sjsjksjxmxmsm/2025e-/docs/手册图_K230接线.jpg

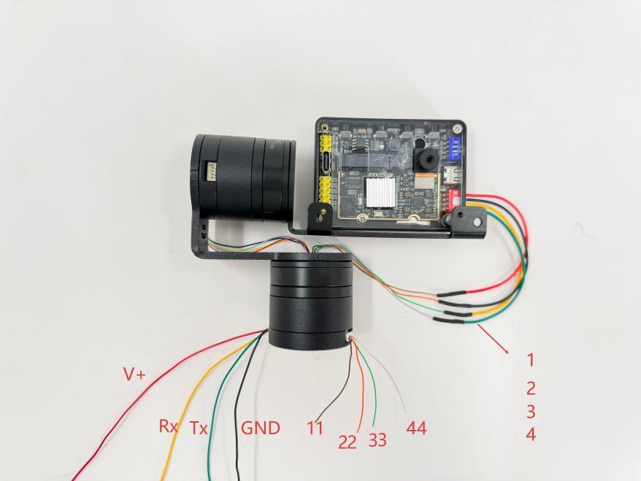
docs/手册图_K230接线.jpg
