sjsjksjxmxmsm/2025e-/docs/实验室大二培训_个人报告.docx

实验室大二培训·个人实践报告

2025 年全国大学生电子设计竞赛 E 题｜简易自行瞄准装置

姓名：____陈俊宇________ 提交日期：2026 年 11 月 ____ 日

本人主要负责：云台与视觉的硬件接线、下位机（STM32）固件开发与联调、激光瞄准补偿标定

填写说明

本报告用于了解你在项目中的真实参与、技术理解和成长过程，不是团队总结，也不是完整的技术论文。请使用自己的语言，如实记录；可以插入图片、关键代码、测试记录及参考来源。文字不必冗长，但要尽可能具体。尚未完成或尚未解决的问题可以直接说明。

# 一、小组分工与个人成果

成员/角色 | 负责内容 | 协作关系或备注
本人： | K230识别，云台电机通信与运动控制、K230 视觉串口通信、MPU6050 陀螺仪接入、OLED 显示、激光补偿标定， | 负责下位机全部固件与接线，是整机联调的接口人
其他成员： | 寻线（循迹）板程序，运行在另一块 MCU 上 | 本板从寻线板接收转向意图；实际转向补偿改由本板陀螺仪自行测量

1. 我的具体任务及实现方法：

本项目中途更换过一次主控板（从厂家原板换到“江协 32 核心板 + 功能底板”，芯片由 STM32F103C8 换成 STM32F103RCT6）。换板之后所有引脚都要重新确认，所以我实际做的工作可以分成四块：

（1）摸清板子并把外设接对。原工程的引脚在新板上一半以上都冲突（例如 PB8 被 OLED 的复位脚占用，而原工程用它接陀螺仪）。我逐个模块查原理图、配合万用表实测，最终确定：云台走 USART1（PA9/PA10，板上 H4 的 TXD1/RXD1）；K230 走 USART3 的默认引脚 PB11（板上 GX_SDA）；MPU6050 用软件 I2C 挂在 PB6/PB7（板上 BL_SCL/BL_SDA，与板载 EEPROM 共总线）；OLED 用四线 SPI 走 PB3/PB4/PB5 加 PB8 复位。

（2）云台电机通信。云台是两轴 BLDC，协议为 0x7A | 地址 | 命令 | 数据 | 校验 | 0x7B，校验为前面字节的异或。实测这台云台的 2 号电机是下面底座（偏航），1 号电机是上面横臂（俯仰），与手册默认顺序相反。偏航用速度模式（发转速），俯仰用多圈位置模式（发绝对角度），这样才能保证俯仰角不漂。

（3）视觉链路。K230 每帧发 8 字节：0x7B、x 高、x 低、y 高、y 低、面积高、面积低、0x7D，坐标是相对画面中心的像素偏移并加了 32768 偏置。STM32 侧用 USART3 的 DMA 加空闲中断接收，收到后解析成 X/Y/面积。实测稳定在 35～38 fps。

（4）闭环控制与激光补偿。用 TIM2 产生 5 ms 周期中断（200 Hz），在中断里跑视觉 PD：误差 = 瞄准点 − 目标像素位置，输出偏航转速与俯仰目标角。瞄准点不是画面中心，而是“激光正好打中目标时目标所在的位置”，这个偏移随距离变化，所以我又用目标面积（面积与距离平方成反比）换算出 √面积，用 √面积做线性修正，实现随距离自适应的补偿。

2. 个人成果与佐证：

成果/完成情况 | 证据位置（截图、代码、测试记录等） | 我的具体贡献
云台能锁定目标并实时跟踪 | OLED 上 N 值稳定增长（35 左右）、X/Y 随目标移动平滑变化 | 独立完成电机协议、控制环与调参
K230 视觉链路打通 | 断电重启后 N 值持续增长；软件 I2C 扫描能同时看到 0x50(EEPROM) 与 0x68(MPU) | 独立完成帧协议对接与故障定位
陀螺仪偏航前馈生效 | OLED 的 G 字段随转动变化；快速甩动装置时云台反向抵抗 | 独立完成软件 I2C 驱动与零偏校准
激光能命中目标中心 | 近距离（面积约 59000）与远距离（面积约 16000）两点实测均命中 | 独立完成两点标定与模型推导
按键触发搜索 | 不按键时不转动，按下后 X 轴慢速扫描；检测到目标立即接管 | 独立完成按键逻辑与状态机

[在此插入必要的实物照片、接线图、代码片段、测试截图等，并注明图题/来源。]

# 二、遇到的问题与解决过程

环节 | 具体记录
问题现象 | 俯仰轴（1 号电机）使能后有保持力、能锁住，但给位置指令完全不动作；同一套代码发速度指令给偏航轴（2 号）却正常。
分析与判断 | 先后排除了接线（万用表确认共地、电平正常）、地址（上位机确认 1 号在线）、使能（电机确实锁住）三个方向后，判断问题出在“位置模式的命令本身没被电机执行”。
采取的尝试 | 第一步试了单圈位置模式 0x0004、0x0002，发两字节角度，无效；第二步换成手册里写明的多圈位置模式 0x0001、改发四字节绝对角度，仍然不动；第三步去翻厂家给的“位置闭环”官方例程，逐行对照。
验证结果 | 对比发现官方例程里有一句我们漏掉的关键设置：位置模式下也要发一次非零的速度（官方用 50）。我们把初始化里的 BLDC_SetSpeed(Y, 0) 改成 30 后，俯仰轴立刻开始正常跟随。
最终结论 | 这颗电机的“多圈位置模式”是带 T 型轨迹规划的：速度参数就是轨迹里匀速段的速度。设为 0 等于要求它以 0 速度走到目标位置，永远到不了，表现出来就是“使能了但不动”。这也解释了为什么速度模式下同样的 0 值没问题——速度模式不规划轨迹。

除上面这个主问题外，这段时间还踩了不少坑，按“现象—原因—解决”整理如下：

① 万用表找不到引脚。现象：知道要用 PB11 接 K230，但板上排针几十根，不知道哪根是 PB11。解决：写了一个“引脚扫描”程序，把几个候选脚同时翻转但占空比不同（50%/30%/12%），万用表量到的平均电压就分别是 1.65V、0.99V、0.40V，一次就能对上号。

② 硬件 I2C 一个设备都扫不到。现象：用 STM32 硬件 I2C1 扫描，连板上已经焊死的 EEPROM 都没应答。分析：怀疑是硬件 I2C 的配置或总线状态有问题。解决：改用软件位翻转（开漏输出 + 自己打时序），同一套引脚立刻扫到了 0x50 和 0x68 两个设备，问题定位在硬件外设这一层，驱动就全部改用软件 I2C。

③ 屏幕能亮但内容是倒的、右边缺两列。分析：查驱动芯片手册发现板上用的是 SH1106 而不是常见的 SSD1306，显存是 132 列、屏只有 128 列，且 COM 扫描方向默认相反。解决：初始化命令 0xC8 改 0xC0 解决上下颠倒，写列地址时统一加 2 的偏移解决左右错位。

④ 上电时俯仰轴猛地甩一下。分析：多圈位置模式的“0 度”是电机自己的绝对零点，不是上电时横臂所在的位置，第一个指令等于让它朝绝对零点冲过去。解决：上电后先发一次“读实际角度”，把这个值存成基准偏移，之后所有角度指令都加上这个偏移；再补一个 1 秒的静默期，让电机先停稳再开始跟踪。上电甩动消失。

⑤ 目标回不到画面中心，总是差一截。分析：代码里有个从原厂例程继承下来的标定值 VISION_CENTER_Y = 9，意思是“瞄准点在画面中心下方 9 像素”，换摄像头后这个值早就没意义了。解决：把 X/Y 的标定残留清零，改成按实测重新标定。

⑥ 误差很小时云台完全不动。分析：俯仰指令累加前做了取整，仰角指令 = round(Kp × 误差)，Kp 是 0.01 时误差小于 50 像素取整结果就是 0，等于有一圈 50 像素的死区；偏航轴同理。解决：两轴都改成“小数累加”——把不足 1 个单位的指令攒在 float 里，攒够 1 再发一次，这样误差再小也能慢慢磨过去，同时不会像“每拍强行走一步”那样冲过头。

⑦ 脱靶后云台往反方向跑。分析：K230 丢目标时发的是 send_target(0, 0, 0)，而 STM32 侧每一帧都更新坐标，于是“最后位置”被 0 覆盖了，“回到最后位置”就变成了“回到画面正中”，方向自然反了。解决：改成只有带目标的帧（面积不为 0）才更新坐标，丢目标的帧保留最后一次有效位置。

⑧ 控制环只在收到帧的那一拍才计算。现象：俯仰指令 99% 的时间是 0，云台像卡住一样。分析：原来用了一个“收到帧”的一次性标志，而视觉 38 fps、控制环 200 Hz，等于每 5 拍里只有 1 拍在算 PD，其余 4 拍都在走搜索分支把指令清零。解决：改成用“帧号有没有变化”判断新数据，没有新数据时用上一帧的值继续算，这样每拍都在闭环里。

⑨ 目标闪一下就开始乱转。分析：只要有一帧面积变成 0 就立刻重新进入搜索。解决：加迟滞——只有连续 200 ms（约 7~8 帧）都没有有效目标才算真丢失。

⑩ 激光笔和镜头不在同一光轴，靠近了打不中。分析：这是视差，偏移量和“激光到镜头的距离 ÷ 目标距离”成正比，目标越远偏移越小。解决：用目标面积反推距离（面积与距离平方成反比），拟合出“瞄准偏移 = 常数项 + 系数 × √面积”的线性模型，只在近、远两个点各测一组数据就能解出这两个未知量，中间距离自动插值。实测两点都命中。

相关证据（如适用）：[插入调试照片 / 日志 / 参数前后对比]

# 三、学习经历与个人收获

学习内容 | 项目开始前的状态 | 学习过程和当前掌握程度
STM32 串口 + DMA + 空闲中断接收 | 只会串口轮询收字节 | 能独立配置 USART+DMA+IDLE 定长帧接收，理解中断优先级与 DMA 通道映射
BLDC 云台协议 | 完全没接触过 | 能看懂帧格式与校验，会拿官方例程反查自己的错误，理解速度/位置/轨迹三者的区别
软件模拟 I2C | 只知道有这个概念 | 能手写位翻转时序（起始、应答、读写），会写总线扫描程序定位地址
无示波器条件下的调试手段 | 只会加 printf | 会用 GPIO 翻转 + 万用表读平均电压来定位引脚、判断信号有无
PID/PD 参数整定 | 只会背公式 | 理解了采样延迟、量化取整、执行器死区对闭环的实际影响，知道“调参数前先测数据”

这次经历中让我印象最深的一项变化（结合具体例子）：

最大的变化是：从“改参数碰运气”变成“先把数据测出来再动手”。

刚上手时，云台一抖我就去改 KP，改完还抖就再改，一个下午换了十几次参数也没个头绪。后来我开始强迫自己先回答三个问题：目标现在到底在画面哪个位置？K230 还看得见它吗？电机收到指令了吗？——只要有任何一个问题答不上来，就不许动参数。

比如俯仰轴不动那次，我一开始也是一直在试模式值（0x0004、0x0002、0x0001 挨个试），折腾了很久。真正解决问题的一步其实是去翻官方例程、把自己发的帧和官方逐字节对比，这才发现差的不是模式而是那个“速度 = 0”。如果一开始就这么查，能省掉大半天。

还有 OLED 那次，一直以为驱动写错了，最后查到板上用的是 SH1106 而不是 SSD1306，换了两条初始化命令就好了。这件事让我意识到：先确认硬件是什么，再谈软件怎么写。

# 四、项目复盘与下一步

1. 目前成果中还有哪些不足，或哪些任务未完成？主要原因是什么？

（1）大误差时仍会过冲。视觉只有 35～38 fps，加上串口和解析的延迟，闭环里大概有 30 ms 的滞后；增益一旦调大就振荡，调小又跟不上，目前是取了一个折中的小增益。

（2）激光补偿只用近、远两点标定，中间距离没有实测验证，模型是否真的线性还缺少第三个点的证据。

（3）俯仰轴是“开环的位置模式”——目标角度靠软件累加，没有读回电机的实际角度。如果横臂被挡住或电机丢步，软件并不知道，长时间运行会有累积偏差。

（4）代码结构比较乱。为了不新建工程文件，我把 MPU6050 的驱动直接塞进了 control.c 里，几百行的控制逻辑和 I2C 时序混在一起，后面自己回头看也要找半天。

2. 如果再给自己一些时间，我会优先改进什么？准备如何验证？

优先改进的第一件事是把俯仰轴改成真正的闭环：用电机回传的实际多圈角度（FB_MULTI_ANGLE）替代软件累加值，这样限位、过冲、丢步都能被真实反映。验证方法是：故意用手挡住横臂让它走不动，再放开，看它能不能自己回到正确角度。

第二件事是让视觉更稳：在 K230 端加“连续 N 帧确认 + 检测框滑动平均”，减少框的跳动；或者在 PD 之外加一个基于目标速度的前馈项，减小滞后。验证方法是记录一段 X/Y 曲线，看抖动幅度有没有下降。

第三件事是补第三个标定点验证激光补偿模型；如果发现不是线性，就改成在图像里直接检测激光亮点做闭环对准，那样任何距离都准。

3. 接下来希望继续学习或尝试的方向：

• 运动控制方向：系统辨识与自整定，学会用频响/阶跃响应来定增益，而不是靠手调。

• 嵌入式软件结构：把代码拆成清晰的驱动层/控制层/应用层，或者尝试用 FreeRTOS 管理多任务。

• 图像处理：激光点检测、亚像素定位，这是把“开环补偿”变成“闭环对准”的关键。

• 调试工具：想学一学用逻辑分析仪和 SWO 打点，比万用表和 printf 效率高得多。
