sjsjksjxmxmsm/2025e-/docs/手册图_云台正反面.jpg

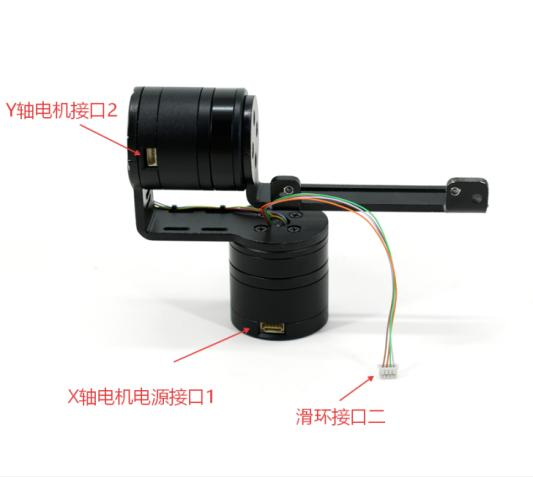
docs/手册图_云台正反面.jpg
