sjsjksjxmxmsm/2025e-/(commit log)

2026-11-08 add firmware/MiniBalance_HARDWARE/BLDC_GIMBAL/DataScope_DP.c
2026-11-08 add firmware/MiniBalance_HARDWARE/ENCODER/encoder.c
2026-11-08 add firmware/MiniBalance_HARDWARE/ENCODER/encoder.h
2026-11-08 add firmware/MiniBalance_HARDWARE/MOTOR/motor.c
2026-11-08 add firmware/MiniBalance_HARDWARE/MOTOR/motor.h
2026-11-08 add firmware/STM32F10x_FWLib/inc/misc.h
2026-11-08 add firmware/STM32F10x_FWLib/inc/stm32f10x_adc.h
2026-11-08 add firmware/STM32F10x_FWLib/inc/stm32f10x_crc.h
2026-11-08 add firmware/STM32F10x_FWLib/inc/stm32f10x_dbgmcu.h
2026-11-08 add firmware/STM32F10x_FWLib/inc/stm32f10x_can.h
2026-11-08 add firmware/STM32F10x_FWLib/inc/stm32f10x_exti.h
2026-11-08 add firmware/STM32F10x_FWLib/inc/stm32f10x_bkp.h
2026-11-08 add firmware/STM32F10x_FWLib/inc/stm32f10x_fsmc.h
2026-11-08 add firmware/STM32F10x_FWLib/inc/stm32f10x_gpio.h
2026-11-08 add firmware/STM32F10x_FWLib/inc/stm32f10x_i2c.h
2026-11-08 add firmware/STM32F10x_FWLib/inc/stm32f10x_dac.h
2026-11-08 add firmware/STM32F10x_FWLib/inc/stm32f10x_pwr.h
2026-11-08 add firmware/STM32F10x_FWLib/inc/stm32f10x_dma.h
2026-11-08 add firmware/STM32F10x_FWLib/inc/stm32f10x_sdio.h
2026-11-08 add firmware/STM32F10x_FWLib/inc/stm32f10x_spi.h
2026-11-08 add firmware/STM32F10x_FWLib/inc/stm32f10x_rtc.h
2026-11-08 add firmware/STM32F10x_FWLib/inc/stm32f10x_tim.h
2026-11-08 add firmware/STM32F10x_FWLib/inc/stm32f10x_wwdg.h
2026-11-08 add firmware/STM32F10x_FWLib/src/misc.c
2026-11-08 add firmware/STM32F10x_FWLib/src/stm32f10x_adc.c
2026-11-08 add firmware/STM32F10x_FWLib/inc/stm32f10x_usart.h
2026-11-08 add firmware/STM32F10x_FWLib/src/stm32f10x_crc.c
2026-11-08 add firmware/STM32F10x_FWLib/src/stm32f10x_bkp.c
2026-11-08 add firmware/STM32F10x_FWLib/src/stm32f10x_dbgmcu.c
2026-11-08 add firmware/STM32F10x_FWLib/src/stm32f10x_can.c
2026-11-08 add firmware/STM32F10x_FWLib/src/stm32f10x_exti.c
2026-11-08 add firmware/STM32F10x_FWLib/src/stm32f10x_dac.c
2026-11-08 add firmware/STM32F10x_FWLib/src/stm32f10x_gpio.c
2026-11-08 add firmware/STM32F10x_FWLib/src/stm32f10x_i2c.c
2026-11-08 add firmware/STM32F10x_FWLib/src/stm32f10x_iwdg.c
2026-11-08 add firmware/STM32F10x_FWLib/src/stm32f10x_pwr.c
2026-11-08 add firmware/STM32F10x_FWLib/src/stm32f10x_rcc.c
2026-11-08 add firmware/STM32F10x_FWLib/src/stm32f10x_sdio.c
2026-11-08 add firmware/STM32F10x_FWLib/src/stm32f10x_spi.c
2026-11-08 add firmware/STM32F10x_FWLib/src/stm32f10x_tim.c
2026-11-08 add firmware/STM32F10x_FWLib/src/stm32f10x_rtc.c
2026-11-08 add firmware/STM32F10x_FWLib/src/stm32f10x_wwdg.c
2026-11-08 add firmware/STM32F10x_FWLib/src/stm32f10x_usart.c
2026-11-08 add firmware/USER/stm32f10x_it.c
2026-11-08 add firmware/USER/stm32f10x_conf.h
2026-11-08 add firmware/USER/stm32f10x_it.h
2026-11-08 add docs/接线与代码解读.md
2026-11-08 add docs/手册图_云台正反面.jpg
2026-11-08 add docs/实验室大二培训_个人报告.docx
2026-11-08 add docs/手册图_K230接线.jpg
2026-11-08 add firmware/MiniBalance_HARDWARE/BLDC_GIMBAL/DataScope_DP.h
2026-11-08 add firmware/STM32F10x_FWLib/inc/stm32f10x_cec.h
2026-11-08 add firmware/STM32F10x_FWLib/inc/stm32f10x_flash.h
2026-11-08 add firmware/STM32F10x_FWLib/inc/stm32f10x_iwdg.h
2026-11-08 add firmware/STM32F10x_FWLib/inc/stm32f10x_rcc.h
2026-11-08 add firmware/STM32F10x_FWLib/src/stm32f10x_cec.c
2026-11-08 add firmware/STM32F10x_FWLib/src/stm32f10x_dma.c
2026-11-08 add firmware/STM32F10x_FWLib/src/stm32f10x_flash.c
2026-11-08 add firmware/STM32F10x_FWLib/src/stm32f10x_fsmc.c
2026-11-08 add firmware/USER/stm32f10x.h
2026-11-08 docs: 完善 README（项目说明、硬件连接、协议、踩坑记录）
